emilerenaud/APP1_S7/FichiersAltium/Project Outputs for APP_1_huom2704/BOM/Bill of Materials-APP_1_huom2704.xlsx

Comment | Description | Designator | Footprint | LibRef | Quantity | Supplier 1 | Supplier Part Number 1
5-1814400-1 | CONN - SMA JACK R/A 50 OHM - TH | J1, J2, J4, J5 | CONN_SMA_5-1814400-1 | CONN_SMA_5-1814400-1 | 4 | Digikey | A97593-ND
410-357-B | MOD - JTAG-SMT3-NC Programming Module For Xilinx FPGA - 18-SMT | M1 | MOD_JTAG_410-357-B | MOD_JTAG_410-357-B | 1 | Digi-Key | 1286-1196-ND
590BD-BDG | TIM - OSC PROG 125MHz ~ 214.999MHz LVDS 3.3V 7PPM EN/DS - 6-SMD | Y2 | OSC_590BD-BDG | OSC_590BD-BDG | 1 | Digi-Key | 590BD-BDG-ND
0154002.DR | FUS - 2 A 125 VAC/VDC - 2-SMD | F1 | FUS_0154XXX.DR | FUS_0154002.DR | 1 | Digi-Key | F1224CT-ND
10118194-0001LF | CON - USB MICRO B RECPT SMT R/A - 4PIN | J7 | CON_USB_10118194-0001LF | CON_USB_10118194-0001LF | 1 | Digi-Key | 609-4618-1-ND
0039300060 | CON - Mini-Fit Through Hole, Right Angle 6 position | J3 | CON_MINIFIT_0039300060 | CON_MINIFIT_0039300060 | 1 | Digi-Key | WM21353-ND
AD8056ARMZ | OPAMP - VFB 300MHZ - 8MSOP | U15 | OPAMP_AD8056ARMZ | OPAMP_AD8056ARMZ | 1 | Digikey | AD8056ARMZ-REEL7CT-ND
AD9146BCPZ | DAC - 16BIT SRL HIGH SPEED - QFN-48 | U14 | DAC_AD9146BCPZ | DAC_AD9146BCPZ | 1 | Digikey | AD9146BCPZ-ND
ADA4927-2YCPZ-R2 | OPAMP - CFA 2.3GHZ - QFN-24 | U17, U22 | OPAMP_ADA4927-2YCPZ-R2 | OPAMP_ADA4927-2YCPZ-R2 | 2 | Digikey | ADA4927-2YCPZ-R2CT-ND
ADS62P48IRGCT | ADC - 14 BIT 210MSPS SUAL - VQFN-64 | U16 | ADC_ADS62P48IRGCT | ADC_ADS62P48IRGCT | 1 | Digikey | 296-24611-1-ND
ADUM3160BRWZ-RL | ISO - DGTL ISO 2.5KV 2CH USB - 16SOIC | ISO1 | ISO_ADUM3160BRWZ-RL | ISO_ADUM3160BRWZ-RL | 1 | Digi-Key | ADUM3160BRWZ-RLCT-ND
ASDMB-25.000MHZ-LC-T | OSC - 25MHz XO (Standard) LVCMOS - 4-SMD, No Lead | Y1 | OSC_ASDMB-25.000MHZ-LC-T | OSC_ASDMB-25.000MHZ-LC-T | 1 | Digi-Key | 535-11730-1-ND
AT25DF321A-MH-T | SPI Serial Flash Memory, 32 Megabit, 100 MHz, 2.7 to 3.6 V, -40 to 85 degC, 8-Pin UDFN (MA1-8), RoHS, Tape and Reel | U12 | 8MA1_UDFN_REN-L | FLA_AT25DF321A-MH-T | 1
B3SN-3012P | SWI - TACT SPST-NO 0.05A 24V - 4-SMD | SW1, SW2, SW3 | SWI_TACT_B3SN-3012P | SWI_TACT_B3SN-3012P | 3 | Digikey | SW261CT-ND
CAP - 0402 | CAP - 0402 | C48, C52, C53, C54, C55, C56, C57, C58, C59, C60, C61, C62, C63, C64, C65, C67, C68, C69, C71, C72, C73, C74, C80, C81, C82, C83, C84, C97, C98, C99, C100, C101, C102, C103, C104, C105, C106, C107, C108, C116, C117, C118, C119, C120, C121, C122, C123, C124, C125, C126, C127, C128, C129, C130, C131, C132, C154, C155, C156, C157, C158, C159, C160, C161, C162, C163, C164, C165, C166, C167, C168, C169, C170, C171, C172, C173, C174, C175, C176, C177, C178, C179, C180, C181, C182, C183, C184, C185, C186, C187, C188, C189, C190, C191, C192, C193, C194, C195, C196, C197, C198, C199, C200, C201, C202, C203, C204, C205, C206, C207, C208, C209 | CAP_0402 | CAP - 0402 | 112
CAP - 0603 | CAP - 0603 | C4, C16, C17, C18, C19, C20, C21, C22, C23, C24, C25, C26, C27, C28, C29, C30, C31, C32, C33, C34, C35, C36, C37, C38, C39, C40, C41, C43, C45, C46, C49, C50, C70, C75, C76, C77, C78, C79, C85, C86, C87, C89, C90, C91, C92, C93, C94, C95, C96, C109, C110, C111, C112, C113, C114, C115, C133, C134, C135, C136, C137, C138, C139, C140, C141, C142, C143, C144, C145, C146, C147, C148, C149, C150, C151, C152, C153 | CAP_0603 | CAP - 0603 | 77
CAP - 0805 | CAP - 0805 | C1, C2 | CAP_0805 | CAP - 0805 | 2
CAP - 1206 | CAP - 1206 | C3, C6, C7, C8, C9, C10, C11, C12, C13, C14, C15, C66 | CAP_1206 | CAP - 1206 | 12
CDCE62005RGZT | TIM - CLK SYNTH JITTER CLEANER 3:5 - QFN-48 | U10 | TIM_CDCE62005RGZT | TIM_CDCE62005RGZT | 1 | Digikey | 296-23947-1-ND
DRV8811PWPR | POW - STEPPER MOTOR DRIVER - SOP-28 | U13 | POW_MOTOR_DRV8811PWPR | POW_MOTOR_DRV8811PWPR | 1 | Digikey | 296-24591-1-ND
FER - 0603 | FER - 0603 | L2, L3, L4, L5, L6, L7, L8, L9, L10, L11 | FER_0603 | FER - 0603 | 10
FER - 1206 | FER - 1206 | L1 | FER_1206 | FER - 1206 | 1
FID 1MM | FID - FIDUCIAL 1MM CIRCLE DOUBLE-SIDED - 1MM | FID1, FID2, FID3 | FID_CIRCLE_1MM | FID_CIRCLE_1MM | 3
H1102NLT | TRANSFO - ETHERNET 10/100B-TX - SMD-16 | T1 | TRANSFO_H1102NLT | TRANSFO_H1102NLT | 1 | Digikey | 553-1532-1-ND
KSZ8091MNXCA | COM - ETHERNET PHY 10/100 - QFN-32 | U7 | COM_ETH_PHY_KSZ8091MNXCA | COM_ETH_PHY_KSZ8091MNXCA | 1 | Digikey | 576-4356-ND
LMZ34002RKGR | REG - DC DC Converter -3V to -17V 2A - 41-B1QFN | U18 | REG_SWR_LMZ34002RKGR | REG_SWR_LMZ34002RKGR | 1 | Digi-Key | 296-44356-1-ND
MAL214699108E3 | CAP - ALU 470uF 20% 50V - 1616 | C88 | CAP_ALU_1616_vishay | CAP_ALU_MAL214699108E3 | 1 | Digikey | 4442PHCT-ND
MAL214699501E3 | CAP - ALU 330uF 20% 16V - 1010 | C5, C42, C44 | CAP_ALU_1010_vishay | CAP_ALU_MAL214699501E3 | 3 | Digikey | 4405PHCT-ND
MAL215099101E3 | CAP - ALU 100uF 20% 50V - 1010 | C47, C51 | CAP_ALU_1010_vishay | CAP_ALU_MAL215099101E3 | 2 | Digikey | 4399PHDKR-ND
MBRB4030T4G | DIO - 30V MAX 40 A - TO-263-3 | D3, D4 | DIO_SCHOTTKY_MBRB4030T4G | DIO_SCHOTTKY_MBRB4030T4G | 2 | Digi-Key | MBRB4030T4GOSCT-ND
MT41J128M16JT-125 | MEM - DDR3 SDRAM 2GBIT 800MHZ - TFBGA-96 | U9 | MEM_DDR3_MT41J128M16JT-125 | MEM_DDR3_MT41J128M16JT-125:K TR | 1 | Digikey | 557-1611-1-ND
OSTTC040162 | CONN - TERMINAL BLOCK 4POS 5MM - TH | J8 | CONN_TERMINAL_OSTTA040161 | CONN_TERMINAL_OSTTC040162 | 1 | Digikey | ED2602-ND
PTH08T241WAZ | REG - MODULE PIP 10A 14VIN - 11-SMD | U3 | REG_SWR_PTH08T241WAZ | REG_SWR_PTH08T241WAZ | 1 | Digi-Key | 296-21339-ND
PTN78020WAH | REG - DC DC CONVERTER 2.5-12.6V 6A - TH | U1 | REG_SWR_PTN78020WAH | REG_SWR_PTN78020WAH | 1 | Digi-Key | 296-20515-ND
RES - 0402 | RES - 0402 | R3, R4, R5, R6, R38, R39, R40, R41, R42, R43, R44, R45, R46, R47, R48, R49, R50, R51, R52, R53, R54, R55, R56, R57, R58, R59, R60, R61 | RES_0402 | RES - 0402 | 28
RES - 0603 | RES - 0603 | R1, R2, R7, R8, R9, R10, R11, R12, R13, R14, R15, R16, R17, R18, R19, R20, R21, R22, R23, R24, R25, R26, R27, R28, R29, R30, R31, R32, R33, R34, R35, R36, R37, R62, R63, R64, R65, R66, R67, R68, R70, R71, R72, R73, R75, R76, R77, R78, R79, R80, R81, R82, R83, R84, R85, R86, R87, R88, R89, R90, R91, R92, R93, R94, R95, R96, R97, R98, R99, R100, R101, R102, R103, R104, R105, R106, R107, R108, R109, R110, R111, R112, R113 | RES_0603 | RES - 0603 | 83
RES - 1206 | RES - 1206 | R69, R74 | RES_1206 | RES - 1206 | 2
RJHSE-5385 | CONN - MOD JACK RJ45 R/A ETHERNET - TH | J6 | CONN_ETHERNET_RJHSE-5385 | CONN_ETHERNET_RJHSE-5385 | 1 | Digikey | RJHSE-5385-ND
SMBJ24CA | TVS - 24V 26.7V 600W - DO214AA | D9, D10, D11, D12 | TVS_PWR_SMBJ36CA | TVS_PWR_SMBJ24CA | 4 | Digi-Key | SMBJ24CALFCT-ND
SML-311DTT86 | LED - 611nM ORANGE 2mA - 0603 | D13, D14, D15, D16 | LED_0603 | LED_SML-311DTT86 | 4 | Digikey | 511-1303-1-ND
SML-311UTT86 | LED - 620nM RED 2mA - 0603 | D5 | LED_0603 | LED_SML-311UTT86 | 1 | Digikey | 511-1304-1-ND
TPD1E1B04DPYR | TVS - TVS DIODE 3.6V 8.5V - 0402 | D1, D2, D6, D7 | TVS_DATA_TPD1E1B04DPYR | TVS_DATA_TPD1E1B04DPYR | 4 | Digi-Key | 296-47364-1-ND
TPD2E001DRLR | TVS - USB TVS DIODE 5.5V - SOT-553 | D8 | TVS_USB_TPD2E001DRLR | TVS_USB_TPD2E001DRLR | 1 | Digi-Key | 296-21883-1-ND
TPS7A3301RGWR | REG - LDO Negative Adjustable 1 Output -1.18V-33V 1A - 20-VQFN (5x5) | U19 | REG_LDO_TPS7A3301RGWR | REG_LDO_TPS7A3301RGWR | 1 | Digi-Key | 296-39502-1-ND
TPS7A4701RGWR | REG - LINEAR POS ADJ 1A - 20VQFN | U5, U6, U11, U20, U21 | REG_TPS7A4701RGWR | REG_LDO_TPS7A4701RGWR | 5 | Digi-Key | 296-37224-1-ND
TPS51200DRCT | REG - DDR TERMINATION/REF REG - 10-VFDFN | U2, U4 | REG_PMIC_TPS51200DRCT | REG_PMIC_TPS51200DRCT | 2 | Digi-Key | 296-23830-1-ND
XC6SLX100-3FGG676C | FPGA - XILINX SPARTAN 6 480 I/O - BGA-676 | U8 | FPGA_XILINX_FGG676 | FPGA_XC6SLX100-3FGG676C | 1 | Digikey | 122-1760-ND
