emilerenaud/APP1_S7/(list of files, drawings)

Other design files:
APP_1_huom2704/APP_1_PCB.PcbDoc
APP_1_rene0901_huom2604/APP_1_rene0901_huom2604.PrjPcb
FichiersAltium/APP_1_ADC_m.SchDoc
FichiersAltium/APP_1_Connectors_m.SchDoc
FichiersAltium/APP_1_DAC_m.SchDoc
FichiersAltium/APP_1_DDR3_m.SchDoc
FichiersAltium/APP_1_DriveMoteur_m.SchDoc
FichiersAltium/APP_1_Ethernet_m.SchDoc
FichiersAltium/APP_1_Flash_m.SchDoc
FichiersAltium/APP_1_FPGA_2.SchDoc
FichiersAltium/APP_1_FPGA_m.SchDoc
FichiersAltium/APP_1_Hiearchic.SchDoc
FichiersAltium/APP_1_huom2704.PrjPcb
FichiersAltium/APP_1_JTAG_m.SchDoc
FichiersAltium/APP_1_Overview.SchDoc
FichiersAltium/APP_1_PCBLib.PcbLib
FichiersAltium/APP_1_PLL_m.SchDoc
FichiersAltium/APP_1_Power_m.SchDoc
FichiersAltium/APP_1_PowerAnalog.SchDoc
FichiersAltium/APP_1_Schlib.SchLib
FichiersAltium/APP_1_Title.SchDoc
FichiersAltium/S7CAS_LIB2023/S7CAS_LIB2023.SchLib
