emilerenaud/APP1_S7/(commit log)

2024-01-12 basic project files
    [APP_1_Title.SchDoc, APP_1_rene0901_huom2604.PrjPcb]
2024-01-12 correction CIP math
    [APP_1_Title.SchDoc, APP_1_rene0901_huom2704.PrjPcb]
2024-01-12 update schematic
    [APP_1_Connectors_e.SchDoc, APP_1_DDR3_e.SchDoc, APP_1_FPGA_e.SchDoc, APP_1_Overview.SchDoc, APP_1_Title.SchDoc, APP_1_rene0901_huom2704.PrjPcb]
2024-01-12 Added _m
    [APP_1_Connectors_m.SchDoc, APP_1_DDR3_m.SchDoc, APP_1_FPGA_m.SchDoc]
2024-01-12 saved project
    [APP_1_rene0901_huom2704.PrjPcb]
2024-01-14 2 projets
    [APP_1_Connectors_e.SchDoc, APP_1_Connectors_m.SchDoc, APP_1_DDR3_e.SchDoc, APP_1_DDR3_m.SchDoc, APP_1_FPGA_e.SchDoc, APP_1_FPGA_m.SchDoc, APP_1_Overview.SchDoc, APP_1_Title.SchDoc]
2024-01-16 DDR3 et FPGA
    [APP_1_DDR3_m.SchDoc, APP_1_FPGA_m.SchDoc, APP_1_huom2704.PrjPcb]
2024-01-16 DDR power supply
    [APP_1_DDR3_e.SchDoc, APP_1_FPGA_e.SchDoc, APP_1_Overview.SchDoc]
2024-01-16 Tite modif
    [APP_1_DDR3_m.SchDoc, APP_1_FPGA_m.SchDoc]
2024-01-23 PLL, stepper
    [APP_1_DDR3_e.SchDoc, APP_1_FPGA_e.SchDoc, APP_1_PLL.SchDoc, APP_1_Prog.SchDoc, APP_1_Stepper.SchDoc, APP_1_rene0901.PrjPcb]
2024-01-23 Update Yolo Swag
    [APP_1_DDR3_m.SchDoc, APP_1_DriveMoteur_m.SchDoc, APP_1_FPGA_m.SchDoc, APP_1_Flash_m.SchDoc, APP_1_PLL_m.SchDoc, APP_1_huom2704.PrjPcb]
2024-01-26 ADC + gitignore
    [APP_1_ADC.SchDoc, APP_1_DAC.SchDoc, APP_1_FPGA_e.SchDoc, APP_1_FlashSPI.SchDoc, APP_1_Prog.SchDoc, APP_1_Schlib.SchLib, APP_1_Stepper.SchDoc, APP_1_rene0901.PrjPcb]
2024-01-27 port ADC
    [APP_1_ADC.SchDoc]
2024-01-27 ethernet + connectors + Prog
    [APP_1_ADC.SchDoc, APP_1_Connectors_e.SchDoc, APP_1_DAC.SchDoc, APP_1_Ethernet.SchDoc, APP_1_Prog.SchDoc, APP_1_rene0901.PrjPcb]
2024-01-28 condo ADC
    [APP_1_ADC_m.SchDoc, APP_1_Power_m.SchDoc]
2024-01-29 fix files in wrong folder
    [APP_1_FlashSPI.SchDoc, APP_1_PLL.SchDoc, APP_1_rene0901.PrjPcb]
2024-01-29 DDR Cap
    [APP_1_DDR3_m.SchDoc]
2024-01-29 TODO dans l'overview
    [APP_1_Connectors_m.SchDoc, APP_1_DDR3_m.SchDoc, APP_1_DriveMoteur_m.SchDoc, APP_1_Ethernet_m.SchDoc, APP_1_Overview.SchDoc, APP_1_PLL_m.SchDoc]
2024-01-30 Bank0 IO
    [BANK0.SchDoc]
2024-01-30 Schémas Bloc Power et APP
    [SchmasBLOC.SchDoc]
2024-01-30 Schema math remis
    [APP_1_ADC_m.SchDoc, APP_1_Connectors_m.SchDoc, APP_1_DAC.SchDoc, APP_1_DAC_m.SchDoc, APP_1_DDR3_e.SchDoc, APP_1_DDR3_m.SchDoc, APP_1_DriveMoteur_m.SchDoc, APP_1_Ethernet.SchDoc]
2024-02-08 Update Port
    [APP_1_Connectors_m.SchDoc, APP_1_DAC_m.SchDoc, APP_1_DDR3_m.SchDoc, APP_1_DriveMoteur_m.SchDoc, APP_1_JTAG_m.SchDoc, APP_1_PLL_m.SchDoc, APP_1_huom2704.PrjPcb]
2024-02-16 Rip Rene
    [APP_1_ADC.SchDoc, APP_1_Connectors_e.SchDoc, APP_1_DAC.SchDoc, APP_1_DDR3_e.SchDoc, APP_1_Ethernet.SchDoc, APP_1_FPGA_e.SchDoc, APP_1_FlashSPI.SchDoc, APP_1_Overview.SchDoc]
2024-02-24 sdpo fhnsadfgn
    [APP_1_PCB.PcbDoc, APP_1_huom2704.PrjPcb]
2024-03-03 start bubush
    [APP_1_Connectors_m.SchDoc]
2024-03-06 Rules, Stackup
    [APP_1_FPGA_m.SchDoc]
2024-03-07 placement de piece et nouveau Stackup
2024-03-07 ethernet et usb
    [APP_1_Connectors_m.SchDoc]
2024-03-09 setup diff pair. Routing DAC SMA + Filter
    [APP_1_Connectors_m.SchDoc, APP_1_DAC_m.SchDoc, APP_1_DDR3_m.SchDoc, APP_1_FPGA_m.SchDoc, APP_1_Flash_m.SchDoc, APP_1_Hiearchic.SchDoc, APP_1_JTAG_m.SchDoc, APP_1_PCBLib.PcbLib]
2024-03-09 add new sheet for negative analog power. Routing DAC, PWR
    [APP_1_Connectors_m.SchDoc, APP_1_DAC_m.SchDoc, APP_1_DriveMoteur_m.SchDoc, APP_1_PowerAnalog.SchDoc, APP_1_Power_m.SchDoc, APP_1_huom2704.PrjPcb]
2024-03-10 fuck lapp
    [APP_1_ADC_m.SchDoc, APP_1_DDR3_m.SchDoc, APP_1_FPGA_2.SchDoc, APP_1_FPGA_m.SchDoc, APP_1_PowerAnalog.SchDoc, APP_1_Power_m.SchDoc, APP_1_huom2704.PrjPcb]
2024-03-10 power plane
    [APP_1_FPGA_2.SchDoc, APP_1_PowerAnalog.SchDoc, APP_1_huom2704.PrjPcb]
2024-03-11 Rules de caca
    [APP_1_DDR3_m.SchDoc, APP_1_FPGA_m.SchDoc, APP_1_huom2704.PrjPcb]
2024-03-11 PCB 2
    [APP_1_huom2704.PrjPcb]
2024-03-11 Je prend PCB ÉMILE
    [APP_1_DDR3_m.SchDoc]
2024-03-12 schematic update
    [APP_1_DDR3_m.SchDoc, APP_1_Ethernet_m.SchDoc, APP_1_FPGA_2.SchDoc, APP_1_huom2704.PrjPcb]
2024-03-12 change pin for layout
    [APP_1_FPGA_2.SchDoc]
2024-03-12 Okkkkkkkkk Lets go
    [APP_1_FPGA_m.SchDoc]
2024-03-13 gerber new
    [APP_1_ADC_m.SchDoc, APP_1_Connectors_m.SchDoc, APP_1_DAC_m.SchDoc, APP_1_DDR3_m.SchDoc, APP_1_DriveMoteur_m.SchDoc, APP_1_Ethernet_m.SchDoc, APP_1_FPGA_2.SchDoc, APP_1_FPGA_m.SchDoc]
